Robast-GmbH/KiCad_Library/(list of files, cad)

Other CAD files:
footprints/Sources/Inductor_SMD/L_Wuerth_WE-TPC-3816.FCStd
footprints/Sources/Package_LGA/Infineon_PG-LLGA-5-1.FCStd
footprints/Sources/Package_SON/X2SON-4_1x1mm_P0.65mm.fcstd
footprints/Sources/Package_TO_SOT_THT/sod-70_P5.08mm.fcstd
footprints/Sources/Inductor_SMD/L_Coilcraft_LPS5030.FCStd
footprints/Sources/Package_SON/X2SON-5_0.8x0.8mm_P0.48mm.fcstd
footprints/Sources/Package_TO_SOT_THT/sod-70.fcstd
