Robast-GmbH/KiCad_Library/(commit log)

2024-02-21 Squashed 'footprints/' content from commit fb6755929
    git-subtree-dir: footprints
    git-subtree-split: fb67559296e710cb9fc73008f620e07a3ca9497c
    [Infineon_PG-LLGA-5-1.FCStd, L_Coilcraft_LPS5030.FCStd, L_Wuerth_WE-TPC-3816.FCStd, X2SON-4_1x1mm_P0.65mm.fcstd, X2SON-5_0.8x0.8mm_P0.48mm.fcstd, sod-70.fcstd, sod-70_P5.08mm.fcstd]
2024-02-21 feat: Adds settings.json for kicad-db-lib
2024-02-21 docs: Adds reference to KiCad-Db-Lib to README
2024-02-21 chore: removes footprint dir because of wrong subtree version
    [Infineon_PG-LLGA-5-1.FCStd, L_Coilcraft_LPS5030.FCStd, L_Wuerth_WE-TPC-3816.FCStd, X2SON-4_1x1mm_P0.65mm.fcstd, X2SON-5_0.8x0.8mm_P0.48mm.fcstd, sod-70.fcstd, sod-70_P5.08mm.fcstd]
2024-02-21 docs: adds KiCad version to subtree add commands
2024-02-21 Squashed 'footprints/' content from commit 1643a594f
    git-subtree-split: 1643a594f30d7c28912c19256050e1cb935979c7
    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
    [Infineon_PG-LLGA-5-1.FCStd, L_Coilcraft_LPS5030.FCStd, L_Wuerth_WE-TPC-3816.FCStd, X2SON-4_1x1mm_P0.65mm.fcstd, X2SON-5_0.8x0.8mm_P0.48mm.fcstd, sod-70.fcstd, sod-70_P5.08mm.fcstd]
2024-02-21 feat: adds `_MCU:ESP32-WROOM-32E-N8`
2024-02-21 chore: adds keywords `Cap Capacitor` to capacitors
2024-02-22 fix: footprint for `_C_0805:1u_50V`
2024-02-22 chore: minor adjustments to to `FUSE_01550900M` footprint
2024-04-10 feat: adds footprint `MountingHole_4mm_Pad_6.15mm_TopOnly`
2024-04-10 feat: adds footprint `MountingHole_3.2mm_M3_Pad_Top_6.4mm_Bottom_9.4mm`
2024-04-11 feat: adds 3D model for `ESP32-WROOM-32E`
2024-04-15 fix: pad numbers of footprint `SW_TS-1187`
2024-04-15 fix: connect GND vias to pads for footprint for `ESP32-WROOM-32E`
2024-04-23 fix: GND vias to pads for footprint for `ESP32-WROOM-32E`
2024-04-23 feat: updates footprint for `USB-Micro` to integrate GND shield
2024-04-23 fix: Shield connection for footprint of `USB-Micro`
2024-04-23 fix: mask for footprint for `USB-Micro`
2024-04-29 feat: adds footprint `MountingHole_3.2mm_M3_Pad_Top_Bottom_9.4mm`
2024-04-29 chore: changing pad size from 9.4 mm to 9.2 mm
2024-08-23 feat: adds new symbol library `Robast_Components` for wiring diagram of complete robot
2024-09-10 feat: adds `Switch_Teltonika_TSW110` to `Robast_Components`
2024-09-10 chore: removes GPIO contact from `Jetson_Orin_NX_16GB`
2024-09-20 feat: adds `path_to_docs` as kicad-db-lib setting
2024-09-20 fix: removes unit from capacity values
2024-09-23 feat: adds resistor `_R_0603:1K2`
2024-09-23 feat: adds RoHS certificate for UNI-ROYAL resistors
2024-09-23 feat: adds resistor `_R_0603:120`
2024-09-23 feat: adds `path_to_docs` for all resistors form manufacturer `UNI-ROYAL`
2024-09-24 feat: adds documents for Molex Micro-Fit Connectors
2024-09-24 feat: adds documents for `Fuse:2A`
2024-09-24 feat: adds documents for `_MCU:ESP32-WROOM-32E-N8`
2024-10-24 feat: adds documents for the leds
2024-11-20 feat: adds `Fan_Sunon_DC_24V/12V` and `Voltage_Converter_Disinfection_Module`
2024-12-18 feat: adds symbol for `WE-CLFS_EMV-Filter`
